AndrejChoo/freq_meter_on_cpld/hardware/pcb_down.jpg

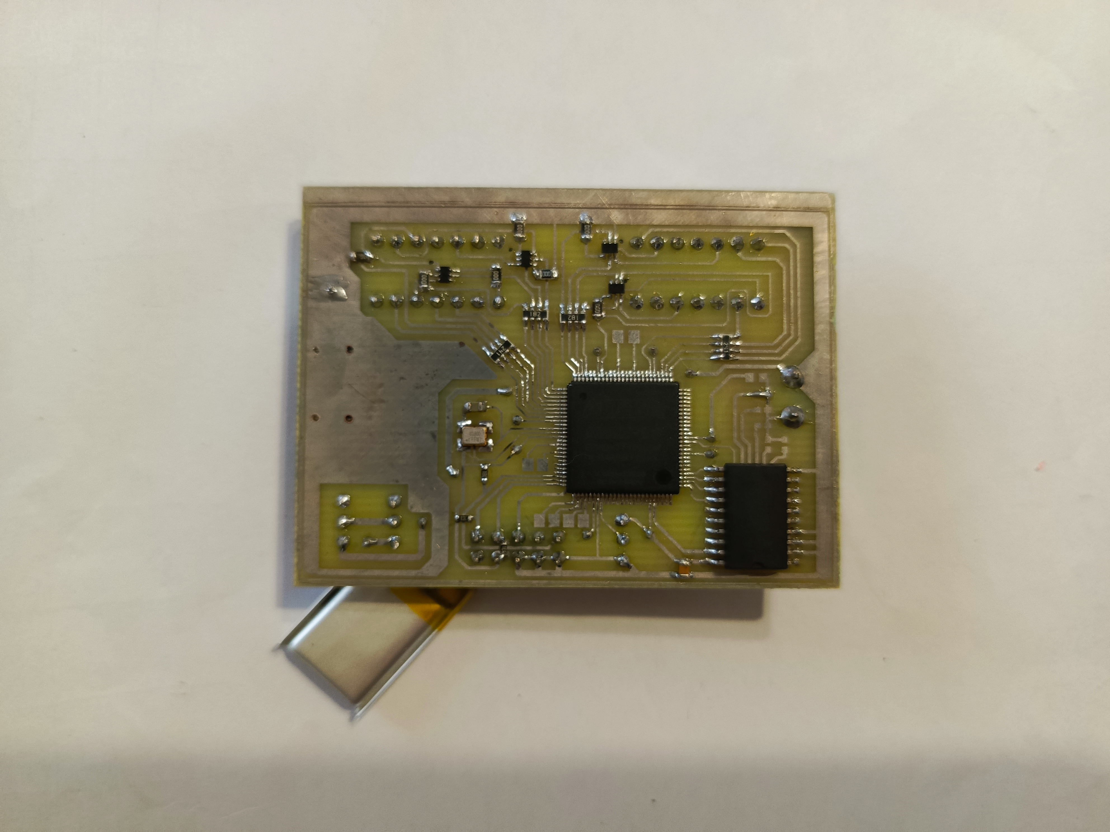
hardware/pcb_down.jpg
