AndrejChoo/freq_meter_on_cpld/hardware/pcb_up.jpg

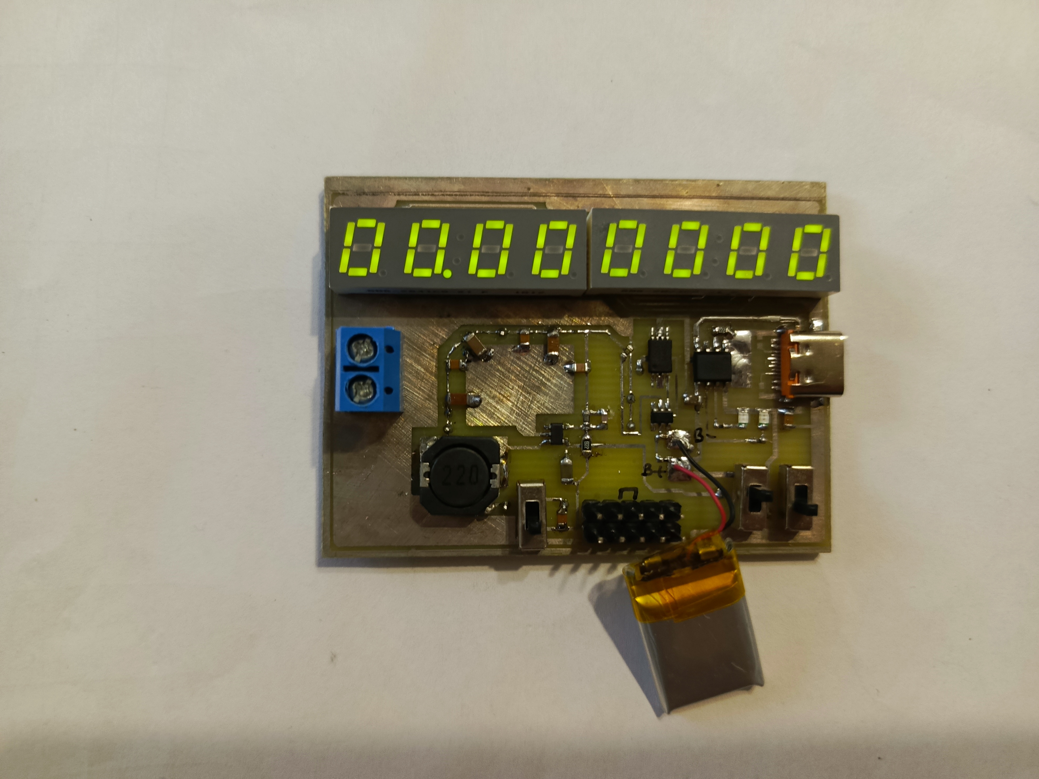
hardware/pcb_up.jpg
