AndrejChoo/freq_meter_on_cpld/hardware/Schematic_FreqMeter.png

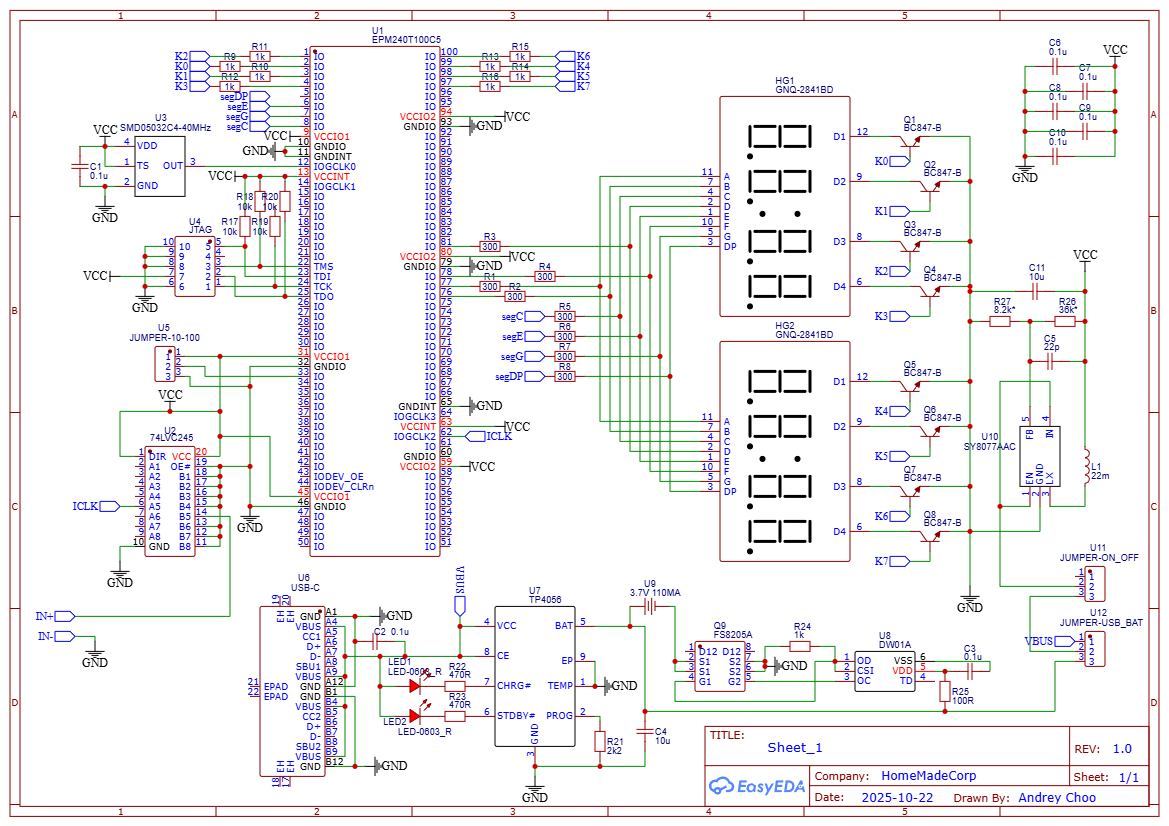
hardware/Schematic_FreqMeter.png
