AndrejChoo/freq_meter_on_cpld/case/FreqMetr_cov.STL

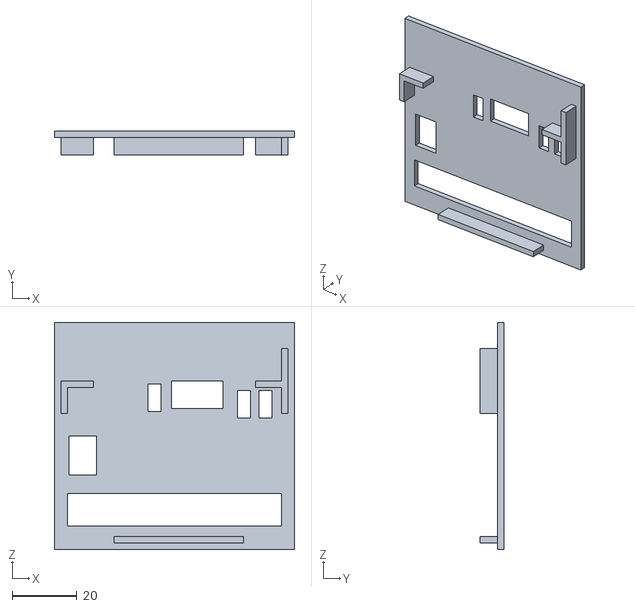
[picture p5: CAD file, 2025-10-23]
case/FreqMetr_cov.STL
74.0 x 7.50 x 70.0
