AndrejChoo/freq_meter_on_cpld/case/FreqMetr_down.STL

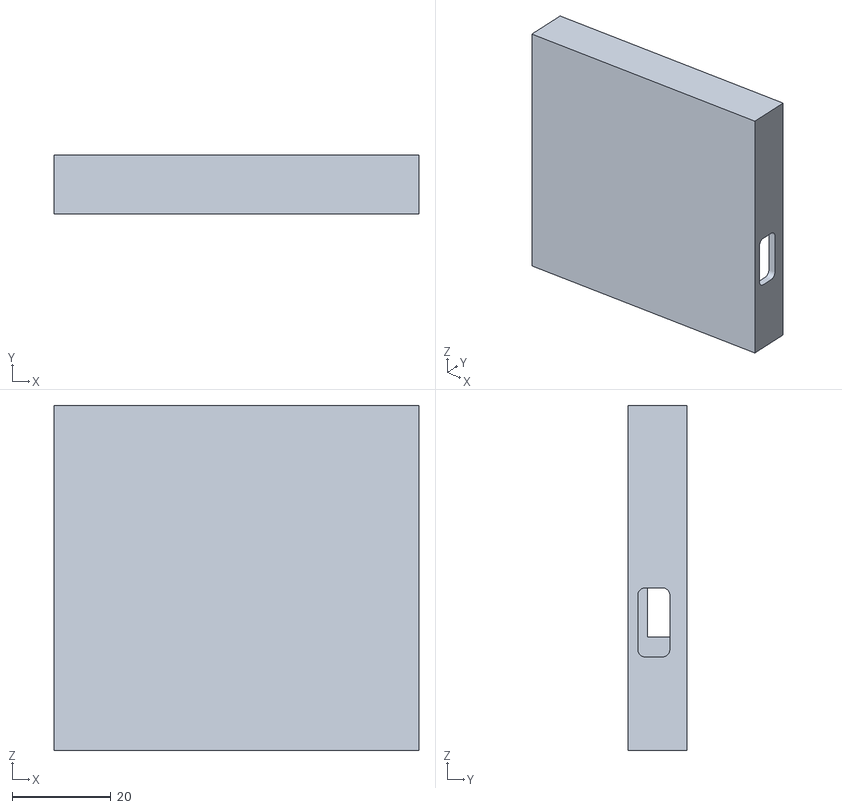
[picture p6: CAD file, 2025-10-23]
case/FreqMetr_down.STL
74.0 x 12.0 x 70.0
