AndrejChoo/freq_meter_on_cpld/hardware/Schematic_FreqMeter.pdf

IO 51 IO 50 IO 49 IO 48 IO 47 GNDIO 46 VCCIO1 45 IODEV_CLRn 44 IODEV_OE 43 IO 42 IO 41 IO 40 IO 39 IO 38 IO 37 IO 36 IO 35 IO 34 IO 33 GNDIO 32 VCCIO1 31 IO 30 IO 29 IO 28 IO 27 IO 26 TDO 25 TCK 24 TDI 23 TMS 22 IO 21 IO 20 IO 19 IO 18 IO 17 IO 16 IO 15 IOGCLK1 14 VCCINT 13 IOGCLK0 12 GNDINT 11 GNDIO 10 VCCIO1 9

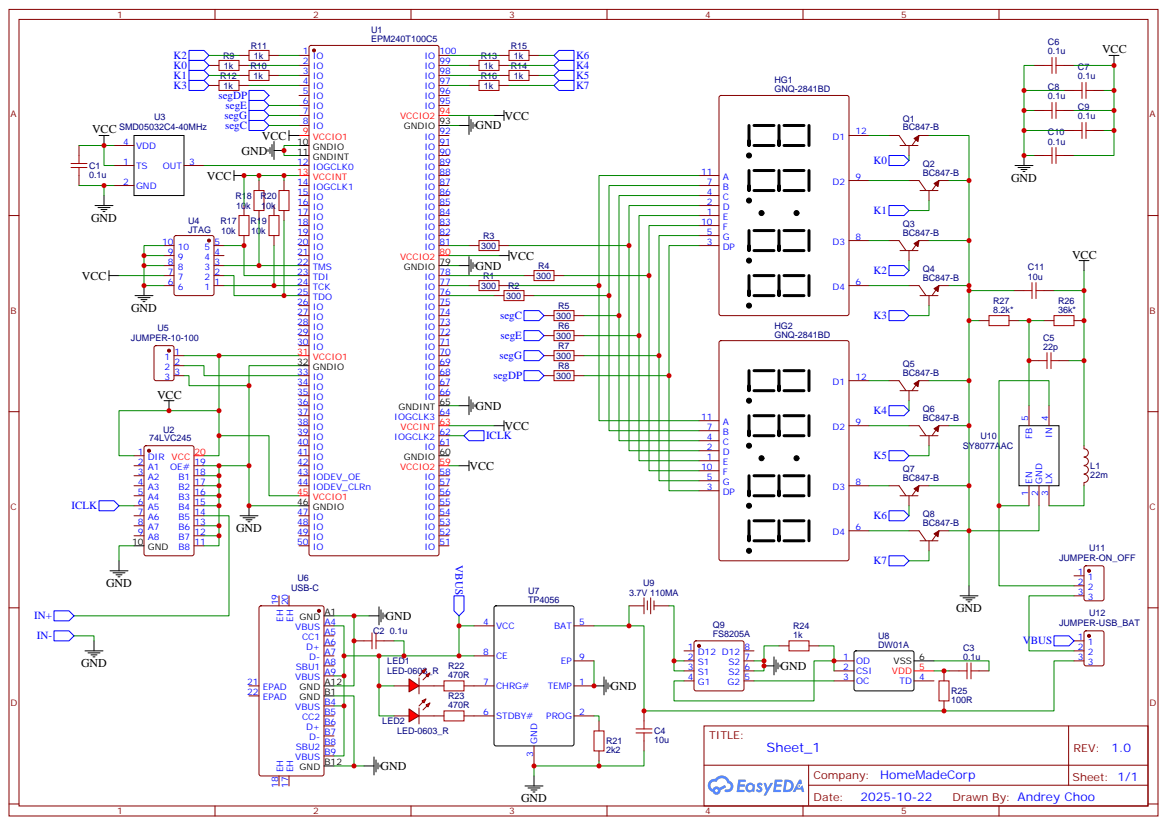
[picture p7: page 1]

Drawn By: Andrey Choo
