AndrejChoo/freq_meter_on_cpld/(list of files, drawings)

Other design files:
hardware/freq_meter.lay6
